amnessa/KiCAD/projects/Attiny_light/Attiny_light/fab/Attiny_light_rev2_BOM.csv

Refs | Value | Footprint | Qty
C1 | 4.7u | Capacitor_SMD:C_0603_1608Metric | 1
C2,C4 | 10u | Capacitor_SMD:C_0603_1608Metric | 2
C3,C6 | 100n | Capacitor_SMD:C_0402_1005Metric | 2
C5 | 10n | Capacitor_SMD:C_0402_1005Metric | 1
J1 | UJC-VP-3-SMT-TR | Attiny_light:USB_C_Receptacle_SameSky_UJC-VP-3-SMT_Vertical | 1
Q1,Q2 | AO3400A | Package_TO_SOT_SMD:SOT-23 | 2
Q3 | FS8205A | Package_TO_SOT_SMD:SOT-23-6 | 1
R1,R2 | 5.1k | Resistor_SMD:R_0402_1005Metric | 2
R3 | 3k | Resistor_SMD:R_0402_1005Metric | 1
R4 | 47 | Resistor_SMD:R_0402_1005Metric | 1
R5,R7,R10 | 100 | Resistor_SMD:R_0402_1005Metric | 3
R6,R8 | 100k | Resistor_SMD:R_0402_1005Metric | 2
R9,R11 | 1k | Resistor_SMD:R_0402_1005Metric | 2
R12 | 10k | Resistor_SMD:R_0402_1005Metric | 1
R13 | 33 | Resistor_SMD:R_0603_1608Metric | 1
U1 | TP4054 | Package_TO_SOT_SMD:SOT-23-5 | 1
U2 | ATtiny85-20S | Package_SO:SOIC-8_5.3x5.3mm_P1.27mm | 1
U3 | DW01A | Package_TO_SOT_SMD:SOT-23-6 | 1
