amnessa/KiCAD/projects/Attiny_light/Attiny_light/fab/assembly_top.pdf

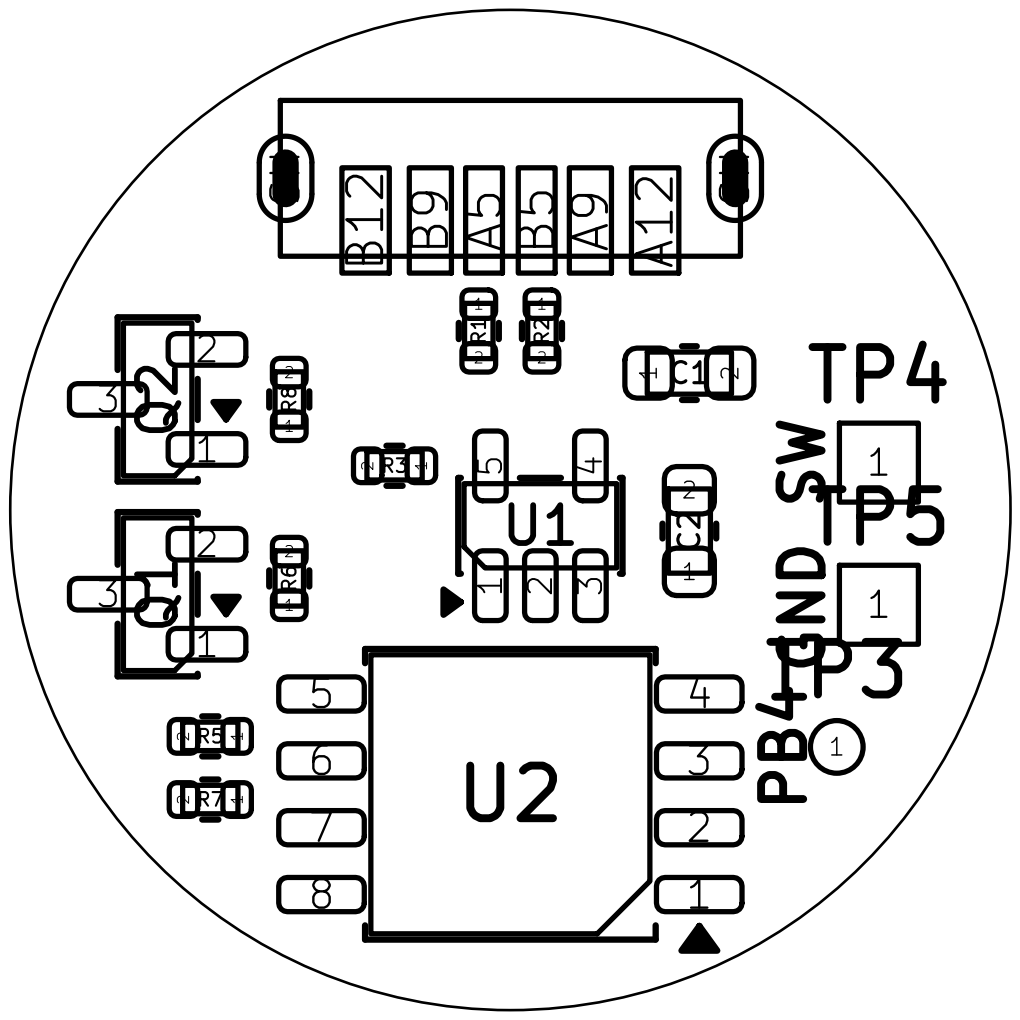
[picture p2: page 1]

Size: A4 | Rev:
KiCad E.D.A. 10.0.8 | Id: 1/1
