amnessa/KiCAD/projects/Attiny_light/Attiny_light/Attiny_light.kicad_pcb

## KiCad design projects/Attiny_light/Attiny_light/Attiny_light.kicad_pcb (2026-11-03)

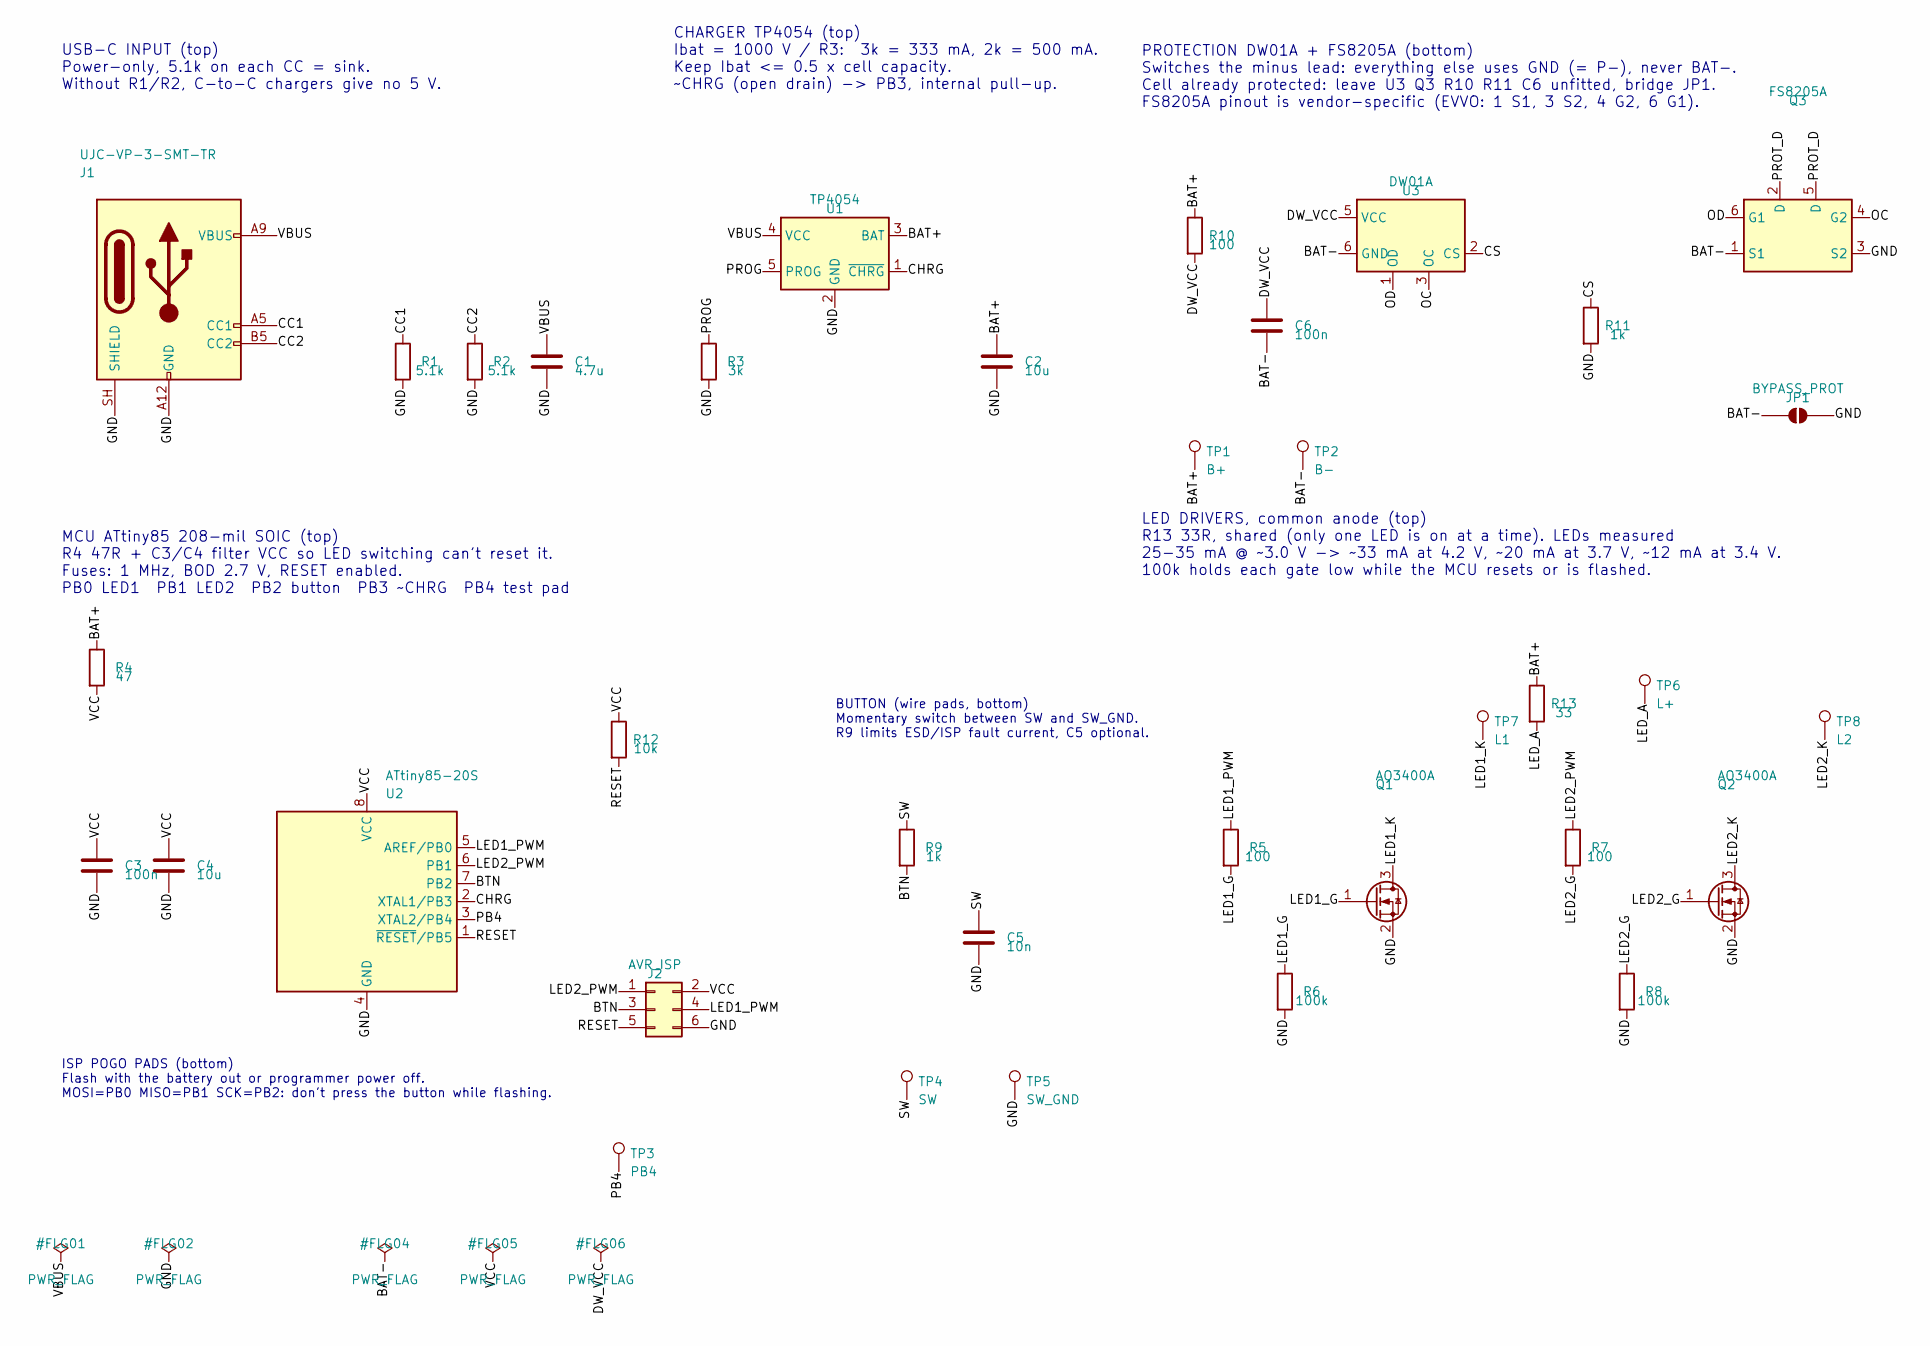
[picture p3: schematic Attiny_light.kicad_sch, Attiny_light - ATtiny85 flashlight driver, D19 mm]

Parts:
C1: 4.7u; C_0603_1608Metric
C2, C4: 10u; C_0603_1608Metric
C3, C6: 100n; C_0402_1005Metric
C5: 10n; C_0402_1005Metric
J1: UJC-VP-3-SMT-TR; USB_C_Receptacle_SameSky_UJC-VP-3-SMT_Vertical
J2: AVR_ISP; AVR_ISP_Pogo_2x03_P2.54mm_SMD
JP1: BYPASS_PROT; SolderJumper-2_P1.3mm_Open_RoundedPad1.0x1.5mm
Q1, Q2: AO3400A; SOT-23
Q3: FS8205A; SOT-23-6
R1, R2: 5.1k; R_0402_1005Metric
R3: 3k; R_0402_1005Metric
R4: 47; R_0402_1005Metric
R5, R7, R10: 100; R_0402_1005Metric
R6, R8: 100k; R_0402_1005Metric
R9, R11: 1k; R_0402_1005Metric
R12: 10k; R_0402_1005Metric
R13: 33; R_0603_1608Metric
TP1: B+; TestPoint_Pad_2.0x2.0mm
TP2: B-; TestPoint_Pad_2.0x2.0mm
TP3: PB4; TestPoint_Pad_D1.0mm
TP4: SW; TestPoint_Pad_1.5x1.5mm
TP5: SW_GND; TestPoint_Pad_1.5x1.5mm
TP6: L+; TestPoint_Pad_1.5x1.5mm
TP7: L1; TestPoint_Pad_1.5x1.5mm
TP8: L2; TestPoint_Pad_1.5x1.5mm
U1: TP4054; SOT-23-5
U2: ATtiny85-20S; SOIC-8_5.3x5.3mm_P1.27mm
U3: DW01A; SOT-23-6

Connections:
/BAT+: C2.1, R4.1, R10.1, R13.1, TP1.1, U1.3 (BAT)
/BAT-: C6.2, JP1.1 (A), Q3.1 (S1), TP2.1, U3.6 (GND)
/BTN: J2.3, R9.2, U2.7 (PB2)
/CC1: J1.A5 (CC1), R1.1
/CC2: J1.B5 (CC2), R2.1
/CHRG: U1.1 (~CHRG), U2.2 (XTAL1/PB3)
/CS: R11.1, U3.2 (CS)
/DW_VCC: C6.1, R10.2, U3.5 (VCC)
/GND: C1.2, C2.2, C3.2, C4.2, C5.2, J1.A12 (GND), J1.B12 (GND), J1.SH (SHIELD), J2.6, JP1.2 (B), Q1.2 (S), Q2.2 (S), Q3.3 (S2), R1.2, R2.2, R3.2, R6.2, R8.2, R11.2, TP5.1, U1.2 (GND), U2.4 (GND)
/LED1_G: Q1.1 (G), R5.2, R6.1
/LED1_K: Q1.3 (D), TP7.1
/LED1_PWM: J2.4, R5.1, U2.5 (AREF/PB0)
/LED2_G: Q2.1 (G), R7.2, R8.1
/LED2_K: Q2.3 (D), TP8.1
/LED2_PWM: J2.1, R7.1, U2.6 (PB1)
/LED_A: R13.2, TP6.1
/OC: Q3.4 (G2), U3.3 (OC)
/OD: Q3.6 (G1), U3.1 (OD)
/PB4: TP3.1, U2.3 (XTAL2/PB4)
/PROG: R3.1, U1.5 (PROG)
/PROT_D: Q3.2 (D), Q3.5 (D)
/RESET: J2.5, R12.2, U2.1 (~RESET/PB5)
/SW: C5.1, R9.1, TP4.1
/VBUS: C1.1, J1.A9 (VBUS), J1.B9 (VBUS), U1.4 (VCC)
/VCC: C3.1, C4.1, J2.2, R4.2, R12.1, U2.8 (VCC)

Notes on the sheet:
CHARGER TP4054 (top) Ibat = 1000 V / R3: 3k = 333 mA, 2k = 500 mA. Keep Ibat <= 0.5 x cell capacity. ~CHRG (open drain) -> PB3, internal pull-up.
ISP POGO PADS (bottom) Flash with the battery out or programmer power off. MOSI=PB0 MISO=PB1 SCK=PB2: don't press the button while flashing.
LED DRIVERS, common anode (top) R13 33R, shared (only one LED is on at a time). LEDs measured 25-35 mA @ ~3.0 V -> ~33 mA at 4.2 V, ~20 mA at 3.7 V, ~12 mA at 3.4 V. 100k holds each gate low while the MCU resets or is flashed.
PROTECTION DW01A + FS8205A (bottom) Switches the minus lead: everything else uses GND (= P-), never BAT-. Cell already protected: leave U3 Q3 R10 R11 C6 unfitted, bridge JP1. FS8205A pinout is vendor-specific (EVVO: 1 S1, 3 S2, 4 G2, 6 G1).
MCU ATtiny85 208-mil SOIC (top) R4 47R + C3/C4 filter VCC so LED switching can't reset it. Fuses: 1 MHz, BOD 2.7 V, RESET enabled. PB0 LED1 PB1 LED2 PB2 button PB3 ~CHRG PB4 test pad
BUTTON (wire pads, bottom) Momentary switch between SW and SW_GND. R9 limits ESD/ISP fault current, C5 optional.
USB-C INPUT (top) Power-only, 5.1k on each CC = sink. Without R1/R2, C-to-C chargers give no 5 V.

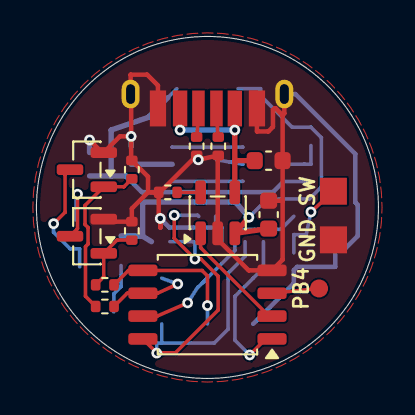
[picture p4: board Attiny_light.kicad_pcb from above]

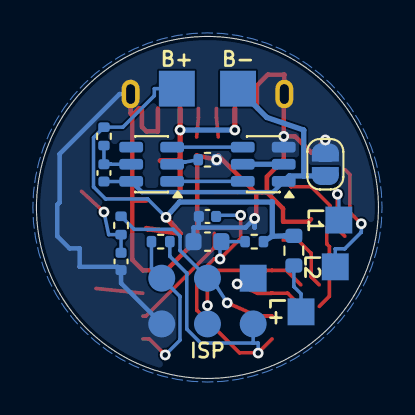
[picture p5: board Attiny_light.kicad_pcb from below]

Board: 2 copper layers, 19.0 x 19.0 mm, 36 parts (19 on the bottom side), 25 nets.
