amnessa/KiCAD/projects/pico_w_module/pico_w_module.kicad_pcb

## KiCad design projects/pico_w_module/pico_w_module.kicad_pcb (2026-04-04)

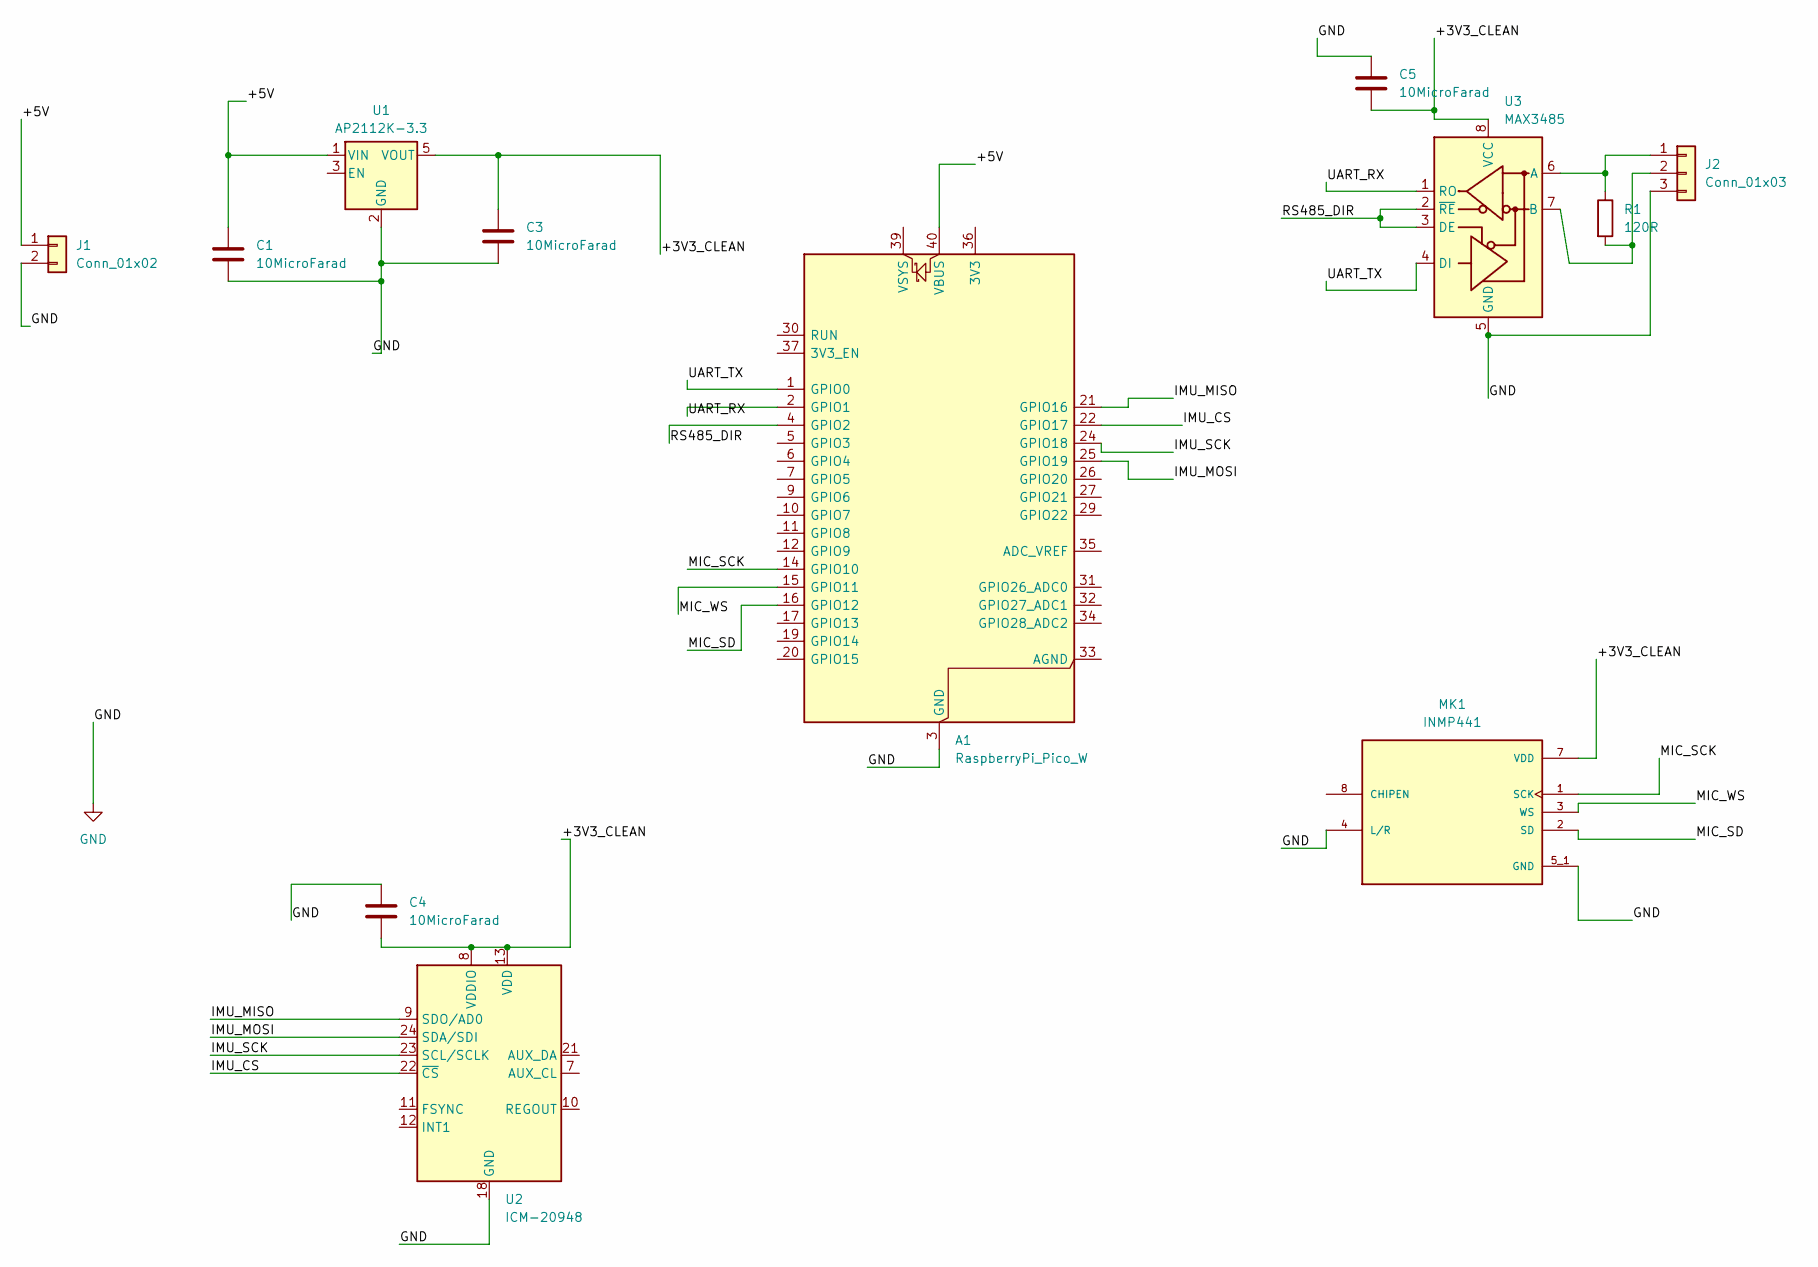
[picture p6: schematic pico_w_module.kicad_sch]

Parts:
A1: RaspberryPi_Pico_W; RaspberryPi_Pico_W_SMD_HandSolder
C1, C3, C4, C5: 10MicroFarad; C_0805_2012Metric_Pad1.18x1.45mm_HandSolder
J1: Conn_01x02; PinSocket_1x02_P2.54mm_Horizontal
J2: Conn_01x03; PinSocket_1x03_P2.54mm_Horizontal
MK1: INMP441; MIC_INMP441; PARTREV 1.1
R1: 120R; C_1206_3216Metric_Pad1.33x1.80mm_HandSolder
U1: AP2112K-3.3; SOT-23-5
U2: ICM-20948; InvenSense_QFN-24_3x3mm_P0.4mm
U3: MAX3485; SOIC-8_3.9x4.9mm_P1.27mm

Connections:
/+3V3_CLEAN: C3.1, C4.2, C5.2, MK1.7 (VDD), U1.5 (VOUT), U2.8 (VDDIO), U2.13 (VDD), U3.8 (VCC)
/+5V: A1.40 (VBUS), C1.1, J1.1, U1.1 (VIN)
/IMU_CS: A1.22 (GPIO17), U2.22 (~CS)
/IMU_MISO: A1.21 (GPIO16), U2.9 (SDO/AD0)
/IMU_MOSI: A1.25 (GPIO19), U2.24 (SDA/SDI)
/IMU_SCK: A1.24 (GPIO18), U2.23 (SCL/SCLK)
/MIC_SCK: A1.14 (GPIO10), MK1.1 (SCK)
/MIC_SD: A1.16 (GPIO12), MK1.2 (SD)
/MIC_WS: A1.15 (GPIO11), MK1.3 (WS)
/RS485_DIR: A1.4 (GPIO2), U3.2 (~RE), U3.3 (DE)
/UART_RX: A1.2 (GPIO1), U3.1 (RO)
/UART_TX: A1.1 (GPIO0), U3.4 (DI)
GND: A1.3 (GND), A1.8 (GND), A1.13 (GND), A1.18 (GND), A1.23 (GND), A1.28 (GND), A1.38 (GND), C1.2, C3.2, C4.1, C5.1, J1.2, J2.3, MK1.4 (L/R), MK1.5_1 (GND), MK1.5_2 (GND), MK1.6 (GND), MK1.9 (GND), U1.2 (GND), U2.18 (GND), U2.20 (GND), U3.5 (GND)
unnamed: J2.1, R1.1, U3.6 (A)
unnamed: J2.2, R1.2, U3.7 (B)

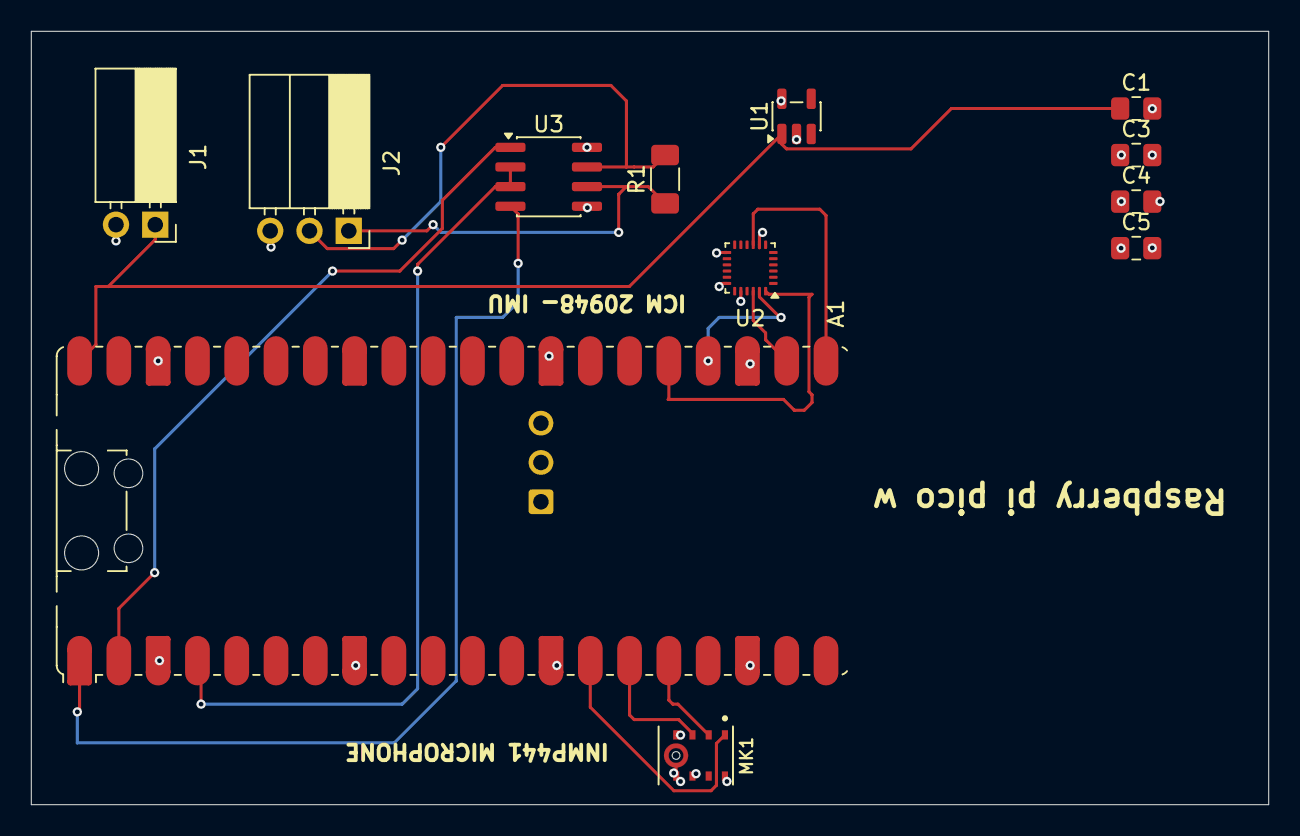
[picture p7: board pico_w_module.kicad_pcb from above]

Board: 4 copper layers, 80.0 x 50.0 mm, 12 parts (0 on the bottom side), 15 nets.
