amnessa/KiCAD/(commit log)

2026-04-03 first commit project welding cell
    [pico_w_module.kicad_pcb, pico_w_module.kicad_sch]
2026-04-04 conceptual version
    [pico_w_module.kicad_pcb, pico_w_module.kicad_sch]
2026-04-04 conception version complete
    [pico_w_module.kicad_pcb]
2026-04-12 attiny prject started
    [Attiny_light.kicad_pcb, Attiny_light.kicad_sch]
2026-04-14 attiny progress to the 3d
    [Attiny_light.kicad_pcb, Attiny_light.kicad_sch]
2026-10-31 Add new components and footprints for Attiny_light project
    - Created symbol library for TP4054 and FS8205A components.
    - Added footprints for AVR ISP pogo pin connector and USB-C receptacle.
    - Updated fp-lib-table and sym-lib-table to include new libraries.
    - Generated lock file for project session.
    [Attiny_light.kicad_sch]
2026-10-31 Update Attiny_light project files for improved design and documentation
    - Adjusted design rules in Attiny_light.kicad_pro for better clearance and track width.
    - Modified schematic Attiny_light.kicad_sch to exclude certain components from BOM and updated footprints for test points and resistors.
    - Corrected USB-C receptacle footprint dimensions in USB_C_Receptacle_SameSky_UJC-VP-3-SMT_Vertical.kicad_mod.
    - Added comprehensive order notes in order_notes.md, detailing assembly instructions, component specifications, and testing procedures.
    [Attiny_light.kicad_pcb, Attiny_light.kicad_sch]
2026-10-31 Update order notes and remove lock file
    - Added PCB layout status section with details on dimensions, part placement, routing, and DRC results.
    - Included pre-order checklist for verifying USB-C connector footprint and pad clearance.
    - Deleted the KiCad lock file as it is no longer needed.
    [Attiny_light.kicad_pcb]
2026-11-03 Add Gerber files and drill files for Attiny_light project
    - Created Attiny_light-F_Paste.gtp for top paste layer.
    - Created Attiny_light-F_Silkscreen.gto for top silkscreen layer.
    - Added Attiny_light-PTH.drl for plated through-hole drill file.
    - Introduced Attiny_light-job.gbrjob for job configuration.
    - Updated order notes with new file generation date and additional details for PCB production.
    [Attiny_light-B_Cu.gbl, Attiny_light-B_Mask.gbs, Attiny_light-B_Paste.gbp, Attiny_light-B_Silkscreen.gbo, Attiny_light-Edge_Cuts.gm1, Attiny_light-F_Cu.gtl, Attiny_light-F_Mask.gts, Attiny_light-F_Paste.gtp]
